pwengel/DIY-GPSDO/README.md

# DIY-GPSDO

Bearbeitet von Lukas

Paste the contents (2 files) of the symbols folder into [for me, this is Dokumente]/KiCad/8.0/symbols/
Symbols for the Pico: https://github.com/ncarandini/KiCad-RP-Pico
