pwengel/DIY-GPSDO/Frequency-Quadrupler-LTSpice/Draft1.asc

A1: xor; Vhigh=5 Vlow=0 Ref=1.0
A2: xor; Vhigh=5 Vlow=0 Ref=1.0
C1: cap; 0.1µ
C2: cap; 40p
C3: cap; 0.1µ
C4: cap; 40p
R1: res; 5.1k
R2: res; 5.1k
R3: res; 2k
R4: res; 5.1k
R5: res; 5.1k
R6: res; 900
U1: LT1720
U2: LT1720
V1: voltage; PULSE(0 5 0 0.1e-12 0.1e-12 0.5e-7 1e-7 200)
V2: voltage; 5
Named nets: 0
RC = 2/(3f_double)
.tran 0 50e-7 0 1e-11
RC = 2/(3f_double)
