pwengel/DIY-GPSDO/GPSDO_DIP/GPSDO_DIP/GPSDO_DIP.kicad_pcb

## KiCad design GPSDO_DIP/GPSDO_DIP/GPSDO_DIP.kicad_pcb (2024-07-01)

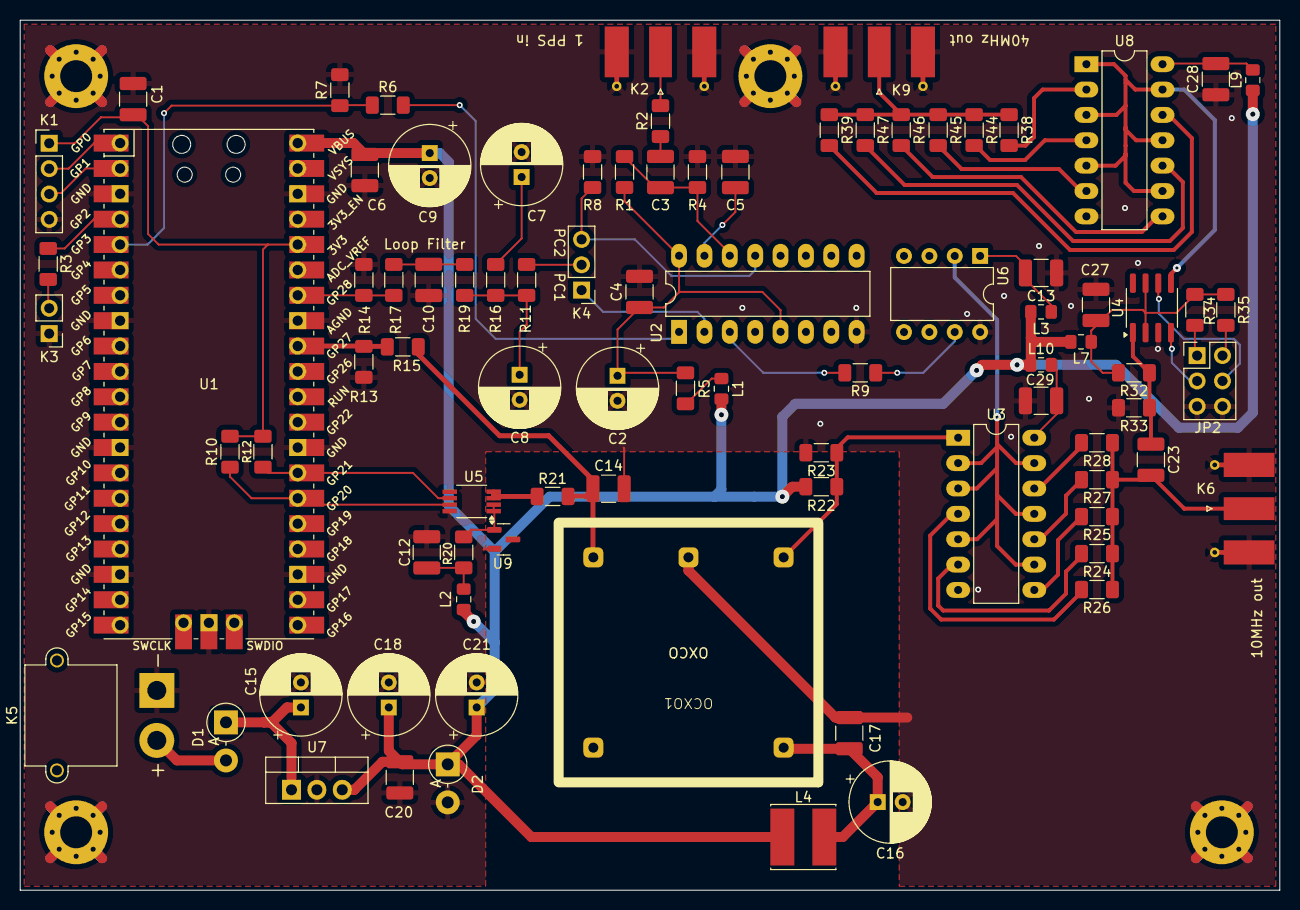
[picture p1: board GPSDO_DIP.kicad_pcb from above]

Board: 2 copper layers, 126.1 x 87.1 mm, 87 parts (0 on the bottom side), 59 nets.

Parts:
C1, C4, C6, C12, C13, C14, C17, C20, C23, C27, C28, C29: 100n; C_1210_3225Metric_Pad1.33x2.70mm_HandSolder
C2, C7, C16, C21: 47µ; CP_Radial_D8.0mm_P2.50mm
C3, C10: 1µ; C_1210_3225Metric_Pad1.33x2.70mm_HandSolder
C5: 2.2n; C_1210_3225Metric_Pad1.33x2.70mm_HandSolder
C8: 22µ; CP_Radial_D8.0mm_P2.50mm
C9: 220µ; CP_Radial_D8.0mm_P2.50mm
C15, C18: 470µ; CP_Radial_D8.0mm_P2.50mm
D1: SS24; D_DO-15_P3.81mm_Vertical_AnodeUp
D2: D; D_DO-15_P3.81mm_Vertical_AnodeUp
JP2: Conn_02x03_Odd_Even; PinHeader_2x03_P2.54mm_Vertical
K1: Conn_01x04; PinHeader_1x04_P2.54mm_Vertical
K2, K6, K9: Conn_Coaxial; SMA_Molex_73251-1153_EdgeMount_Horizontal
K3: Conn_01x02; PinHeader_1x02_P2.54mm_Vertical
K4: Jumper_3_Open; PinHeader_1x03_P2.54mm_Vertical
K5: Conn_01x02; AMASS_XT30PW-M_1x02_P2.50mm_Horizontal
L1, L2: 100µ; L_0805_2012Metric_Pad1.15x1.40mm_HandSolder
L3, L7, L9, L10: 10µ; L_0805_2012Metric_Pad1.15x1.40mm_HandSolder
L4: 10µ; L_Cenker_CKCS6045
OCXO1: OSC5A2B02
R1, R4, R16, R22, R23: 22k; R_1206_3216Metric_Pad1.30x1.75mm_HandSolder
R2, R19, R24, R25, R26, R27, R28, R38, R39, R44, R45, R46, R47: 240; R_1206_3216Metric_Pad1.30x1.75mm_HandSolder
R3, R20: 1k; R_1206_3216Metric_Pad1.30x1.75mm_HandSolder
R5: 22; R_1206_3216Metric_Pad1.30x1.75mm_HandSolder
R6, R15, R17: 27k; R_1206_3216Metric_Pad1.30x1.75mm_HandSolder
R7, R13, R14: 47k; R_1206_3216Metric_Pad1.30x1.75mm_HandSolder
R8: 1M; R_1206_3216Metric_Pad1.30x1.75mm_HandSolder
R9, R21: 680; R_1206_3216Metric_Pad1.30x1.75mm_HandSolder
R10, R12: 10k; R_1206_3216Metric_Pad1.30x1.75mm_HandSolder
R11: 160k; R_1206_3216Metric_Pad1.30x1.75mm_HandSolder
R32, R33: 100k; R_1206_3216Metric_Pad1.30x1.75mm_HandSolder
R34, R35: 4.7k; R_1206_3216Metric_Pad1.30x1.75mm_HandSolder
U1: Pico; RPi_Pico_SMD_TH
U2: DIP-16_W7.62mm_LongPads
U3, U8: 74HC14; DIP-14_W7.62mm_LongPads
U4: U1; SOIC-8_3.9x4.9mm_P1.27mm
U5: DAC8571IDGK; VSSOP-8_3.0x3.0mm_P0.65mm
U6: PIC12F675-xP; DIP-8_W7.62mm
U7: LM7805_TO220; TO-220-3_Vertical
U9: LM4040DBZ-4.1; SOT-23

Connections:
/VCC: C6.1, C7.1, C18.1, C20.1, C21.1, D2.1 (K), L1.2, L2.2, L3.1, L4.1, L7.2, L9.1, L10.1, R22.1, U1.40 (VBUS), U7.3 (VO)
/V_LPF: C10.2, R17.2, R19.1
/V_OCXO: C14.1, OCXO1.3 (Vcont), R15.2, R21.1
GND: C1.2, C2.2, C4.2, C5.1, C6.2, C7.2, C8.2, C9.2, C10.1, C12.2, C13.1, C14.2, C15.2, C16.2, C17.2, C18.2, C20.2, C21.2, C27.2, C28.1, C29.1, D2.2 (A), JP2.5, JP2.6, K1.4, K2.2 (Ext), K3.1, K5.1, K6.2 (Ext), K9.2 (Ext), OCXO1.2 (GND), R4.2, R7.2, R8.2, R13.2, R14.2, R23.2, R33.2, U1.3 (GND), U1.8 (GND), U1.13 (GND), U1.18 (GND), U1.23 (GND), U1.28 (GND), U1.33 (AGND), U1.38 (GND), U1.42 (GND), U2.8 (GND), U3.7 (GND), U4.3 (GND), U5.5 (A0), U5.8 (GND), U6.8 (VSS), U7.2 (GND), U8.7 (GND), U9.2 (A)
unnamed: C3.1, R2.1
unnamed: C8.1, R11.2, R16.1, R19.2
unnamed: C9.1, R16.2
unnamed: C12.1, L2.1, R20.1
unnamed: D1.2 (A), K5.2
unnamed: C15.1, D1.1 (K), U7.1 (VI)
unnamed: JP2.1, R34.1
unnamed: JP2.2, R35.2
unnamed: JP2.3, U4.4 (S1)
unnamed: JP2.4, U4.6 (S0)
unnamed: C1.1, K1.1, R10.2, R12.2, U1.36 (3V3)
unnamed: K1.2, U1.1 (GPIO0)
unnamed: K1.3, U1.2 (GPIO1)
unnamed: K2.1 (In), R2.2
unnamed: K3.2, R3.2
unnamed: K4.1 (A), U2.2 (PC1_out)
unnamed: K4.3 (B), R8.1, U2.13 (PC2_out)
unnamed: K4.2 (C), R11.1
unnamed: C23.2, K6.1 (In), R24.1, R25.1, R26.1, R27.1, R28.1
unnamed: K9.1 (In), R38.1, R39.1, R44.1, R45.1, R46.1, R47.1
unnamed: L1.1, R5.1
unnamed: OCXO1.1 (10MHz), R22.2, R23.1, U3.1
unnamed: C16.1, C17.1, L4.2, OCXO1.5 (VCC)
unnamed: R24.2, U3.6
unnamed: R25.2, U3.8
unnamed: R26.2, U3.4
unnamed: R27.2, U3.10
unnamed: R28.2, U3.12
unnamed: R38.2, U8.2
unnamed: R39.2, U8.12
unnamed: R44.2, U8.4
unnamed: R45.2, U8.6
unnamed: R46.2, U8.8
unnamed: R47.2, U8.10
unnamed: R3.1, U1.4 (GPIO2)
unnamed: R6.1, R7.1, U1.5 (GPIO3)
unnamed: R10.1, U1.26 (GPIO20), U5.7 (SDA)
unnamed: R12.1, U1.27 (GPIO21), U5.6 (SCL)
unnamed: R13.1, R15.1, U1.32 (GPIO27_ADC1)
unnamed: R14.1, R17.1, U1.34 (GPIO28_ADC2)
unnamed: R9.2, U2.3 (COMP_in)
unnamed: C5.2, U2.15 (C_LD)
unnamed: C2.1, C4.1, R1.1, R5.2, U2.5 (INH), U2.16 (VCC)
unnamed: R6.2, U2.1 (LD)
unnamed: C3.2, R1.2, R4.1, U2.14 (SIG_in)
unnamed: C29.2, L10.2, U3.14 (VCC)
unnamed: U4.5 (CLK), U8.1, U8.3, U8.5, U8.9, U8.11, U8.13
unnamed: C27.1, L7.1, R32.1, R34.2, R35.1, U4.2 (VDD), U4.7 (OE)
unnamed: C23.1, R32.2, R33.1, U4.1 (X1/CLK)
unnamed: R20.2, U5.1 (V_{DD}), U5.2 (V_{REF}), U9.1 (K)
unnamed: R21.2, U5.3 (V_{SENSE}), U5.4 (V_{OUT})
unnamed: R9.1, U6.7 (GP0)
unnamed: U3.2, U3.3, U3.5, U3.9, U3.11, U3.13, U6.2 (GP5)
unnamed: C13.2, L3.2, U6.1 (VDD)
unnamed: C28.2, L9.2, U8.14 (VCC)
