pwengel/DIY-GPSDO/GPSDO/GPSDO.kicad_pcb

## KiCad design GPSDO/GPSDO.kicad_pcb (2024-06-26)

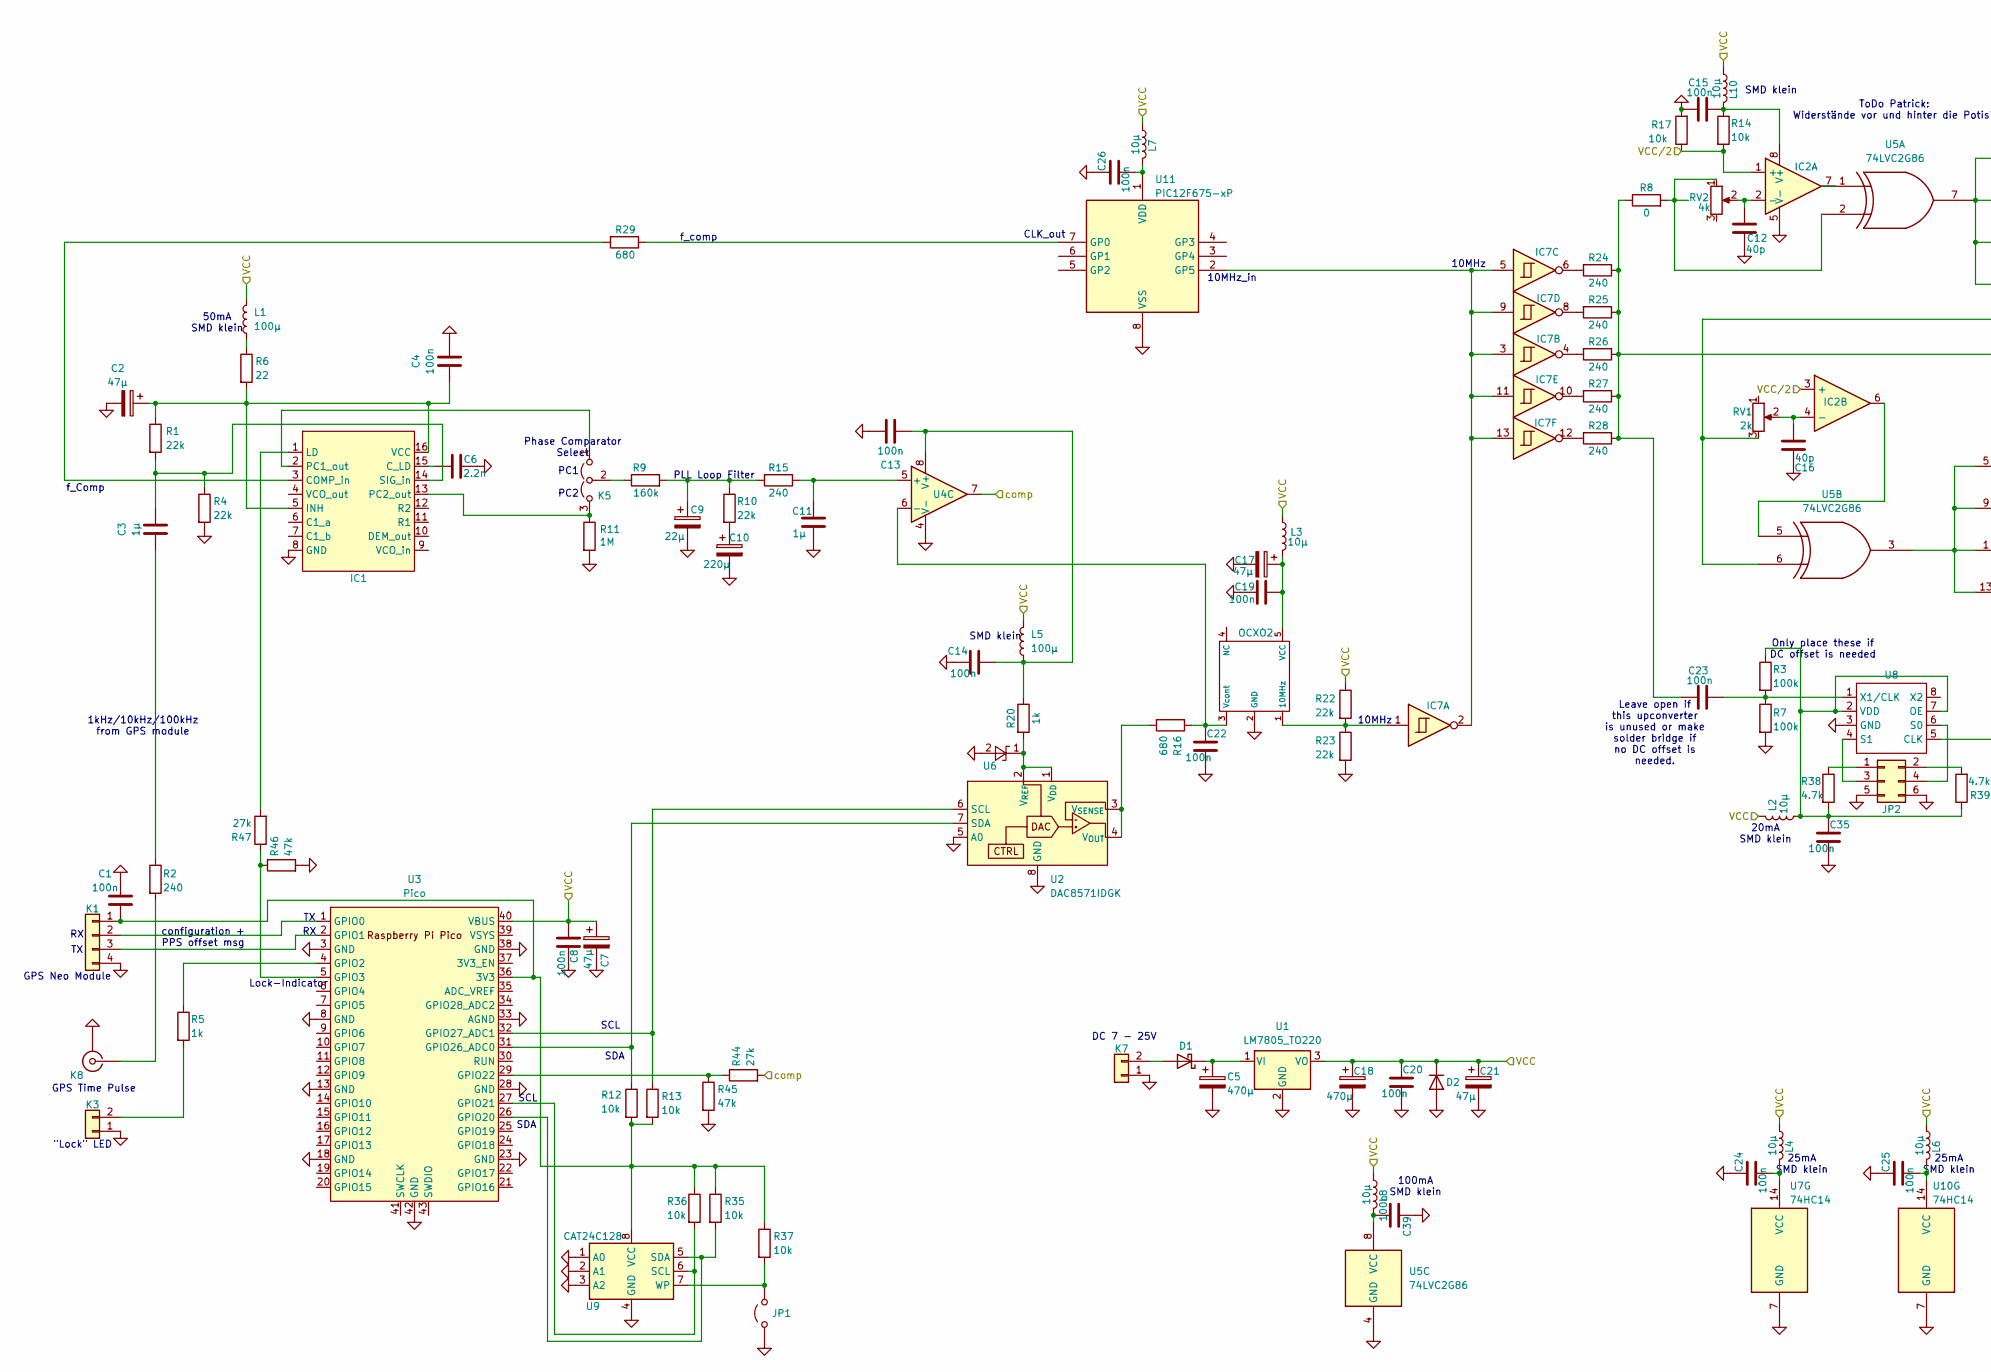
[picture p2: schematic GPSDO.kicad_sch, part in row 1, column 1]

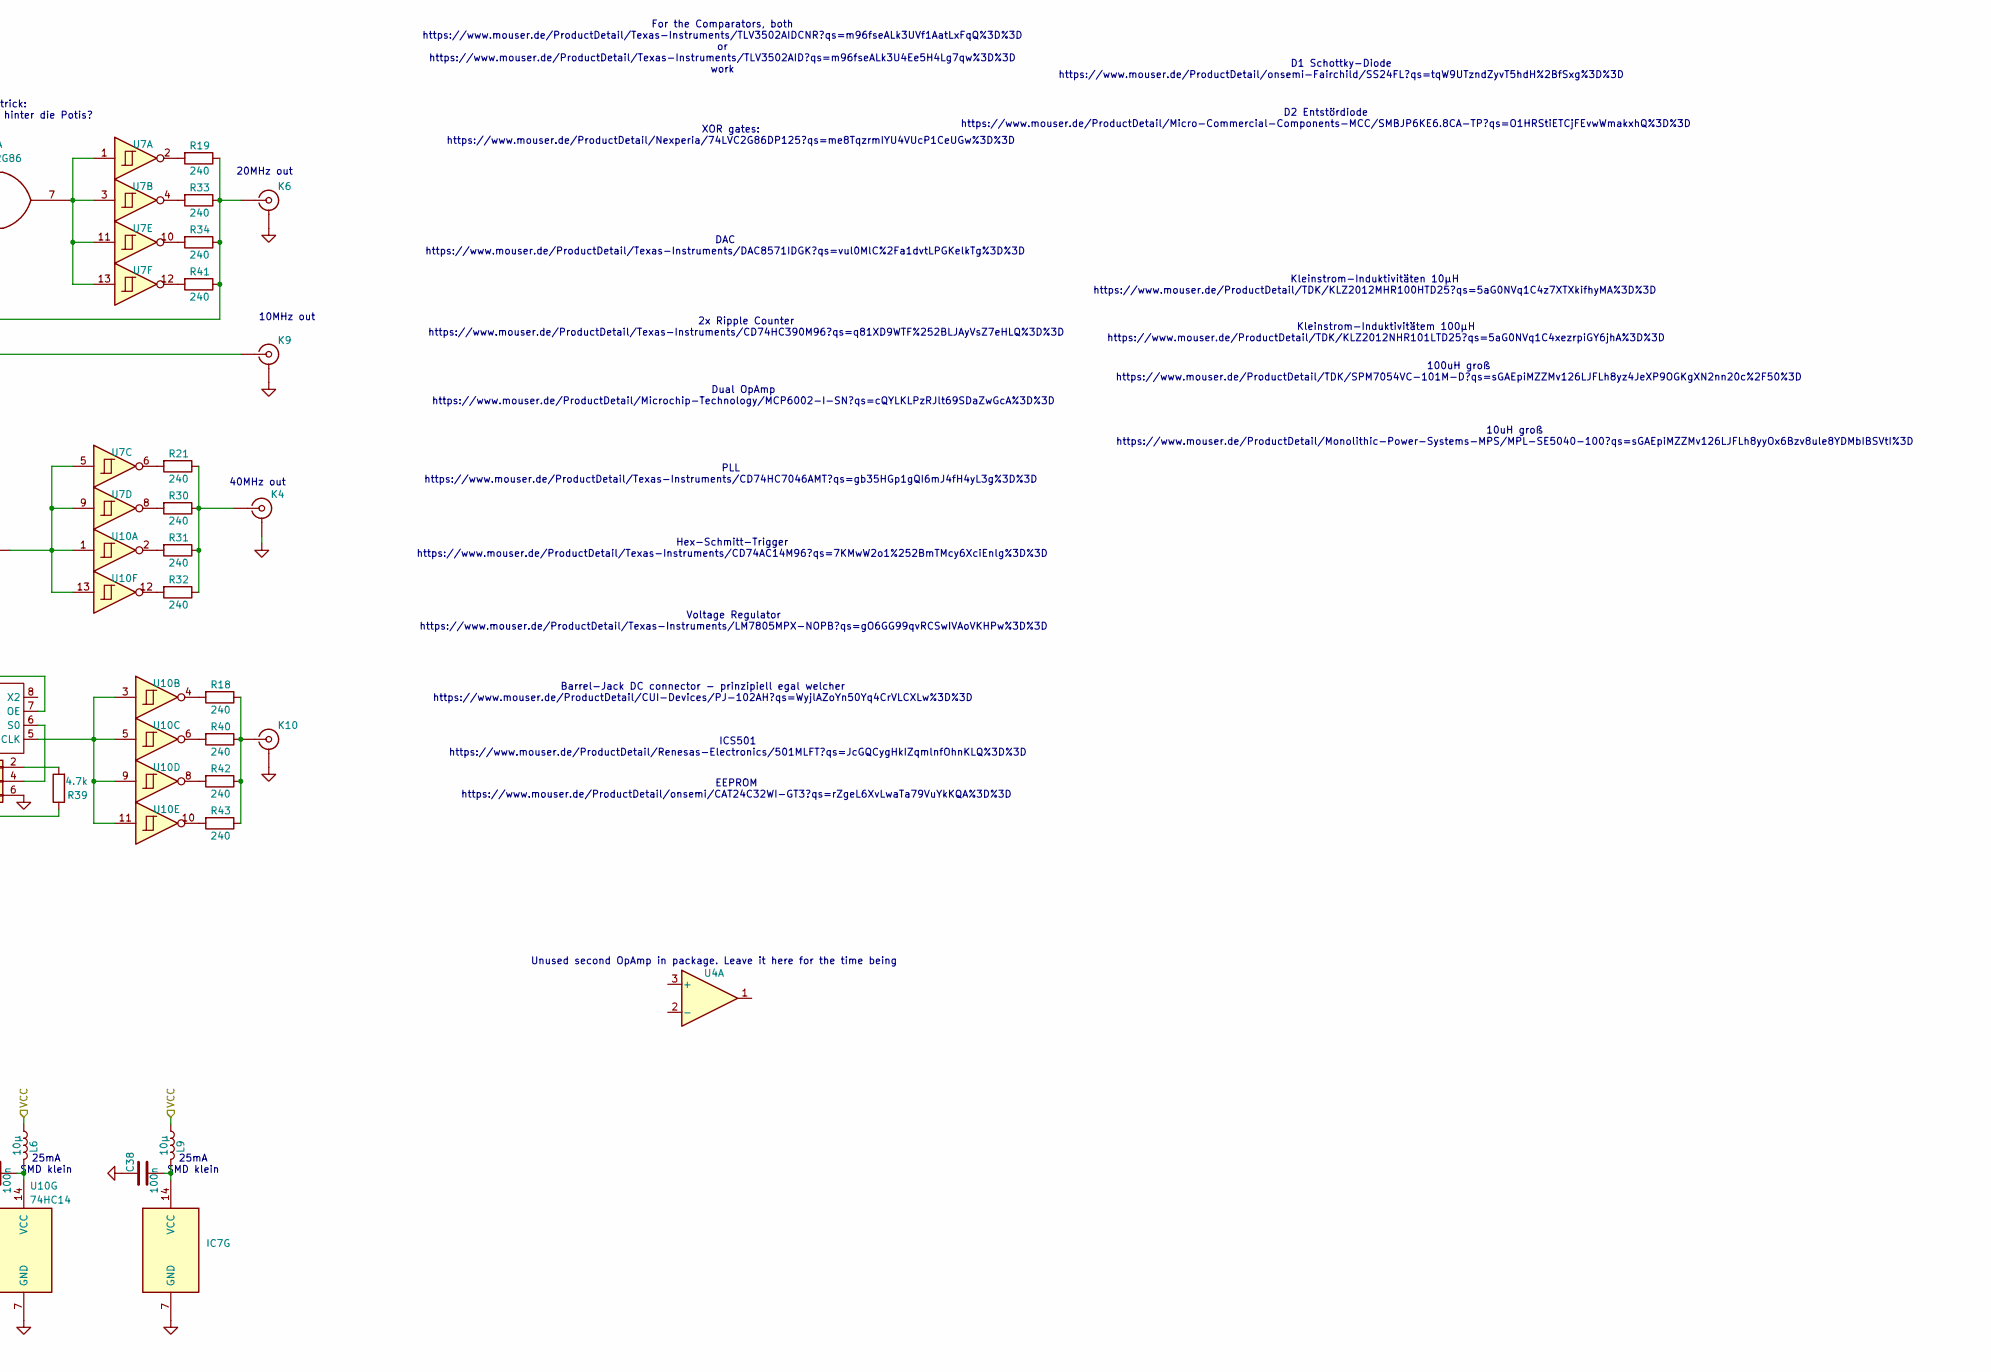
[picture p3: schematic GPSDO.kicad_sch, part in row 1, column 2]

Parts:
C1, C4, C8, C13, C14, C15, C19, C20, C22, C23, C24, C25, C26, C35, C38, C39: 100n; C_1210_3225Metric_Pad1.33x2.70mm_HandSolder
C2, C7, C17, C21: 47µ; CP_Elec_4x5.3
C3, C11: 1µ; C_Rect_L7.2mm_W5.5mm_P5.00mm_FKS2_FKP2_MKS2_MKP2
C5, C18: 470µ; CP_Elec_6.3x9.9
C6: 2.2n; C_1210_3225Metric_Pad1.33x2.70mm_HandSolder
C9: 22µ; CP_EIA-7343-43_Kemet-X_Pad2.25x2.55mm_HandSolder
C10: 220µ; CP_EIA-7343-43_Kemet-X_Pad2.25x2.55mm_HandSolder
C12, C16: 40p; C_1210_3225Metric_Pad1.33x2.70mm_HandSolder
D1: SS24; D_SOD-123F
D2: D; D_SMB
IC1: SOIC-16_3.9x9.9mm_P1.27mm
IC2: SOT-23-8_Handsoldering
IC7: 74HC14; SOIC-14_3.9x8.7mm_P1.27mm
JP1: Jumper_2_Open; PinHeader_1x02_P2.54mm_Vertical
JP2: Conn_02x03_Odd_Even; PinHeader_2x03_P2.54mm_Vertical
K1: Conn_01x04; PinHeader_1x04_P2.54mm_Vertical
K3: Conn_01x02; PinHeader_1x02_P2.54mm_Vertical
K4, K6, K8, K9, K10: Conn_Coaxial; SMA_Molex_73251-1153_EdgeMount_Horizontal
K5: Jumper_3_Open; PinHeader_1x03_P2.54mm_Vertical
K7: Conn_01x02; AMASS_XT30PW-M_1x02_P2.50mm_Horizontal
L1, L5: 100µ; L_0805_2012Metric_Pad1.15x1.40mm_HandSolder
L2, L4, L6, L7, L8, L9, L10: 10µ; L_0805_2012Metric_Pad1.15x1.40mm_HandSolder
L3: 10µ; L_Cenker_CKCS6045
OCXO2: OSC5A2B02
R1, R4, R10, R22, R23: 22k; R_0805_2012Metric_Pad1.20x1.40mm_HandSolder
R2, R15, R18, R19, R21, R24, R25, R26, R27, R28, R30, R31, R32, R33, R34, R40, R41, R42, R43: 240; R_0805_2012Metric_Pad1.20x1.40mm_HandSolder
R3, R7: 100k; R_0805_2012Metric_Pad1.20x1.40mm_HandSolder
R5, R20: 1k; R_0805_2012Metric_Pad1.20x1.40mm_HandSolder
R6: 22; R_0805_2012Metric_Pad1.20x1.40mm_HandSolder
R8: 0; R_0805_2012Metric_Pad1.20x1.40mm_HandSolder
R9: 160k; R_0805_2012Metric_Pad1.20x1.40mm_HandSolder
R11: 1M; R_0805_2012Metric_Pad1.20x1.40mm_HandSolder
R12, R13, R14, R17, R35, R36, R37: 10k; R_0805_2012Metric_Pad1.20x1.40mm_HandSolder
R16, R29: 680; R_0805_2012Metric_Pad1.20x1.40mm_HandSolder
R38, R39: 4.7k; R_0805_2012Metric_Pad1.20x1.40mm_HandSolder
R44, R47: 27k; R_0805_2012Metric_Pad1.20x1.40mm_HandSolder
R45, R46: 47k; R_0805_2012Metric_Pad1.20x1.40mm_HandSolder
RV1: 2k; Potentiometer_Bourns_3314S_Horizontal
RV2: 4k; Potentiometer_Bourns_3314J_Vertical
U1: LM7805_TO220; SOT-223-3_TabPin2
U2: DAC8571IDGK; VSSOP-8_3.0x3.0mm_P0.65mm
U3: Pico; RPi_Pico_SMD_TH
U4: AD8620; SOIC-8_3.9x4.9mm_P1.27mm
U5: 74LVC2G86; TSSOP-8_3x3mm_P0.65mm
U6: LM4040DBZ-4.1; SOT-23
U7, U10: 74HC14; SOIC-14_3.9x8.7mm_P1.27mm
U8: U1; SOIC-8_3.9x4.9mm_P1.27mm
U9: CAT24C128; SOIC-8_3.9x4.9mm_P1.27mm
U11: PIC12F675-xP; DIP-8_W7.62mm

Connections:
/VCC: C7.1, C8.1, C18.1, C20.1, C21.1, D2.1 (K), L1.2, L2.2, L3.1, L4.1, L5.2, L6.1, L7.1, L8.1, L9.1, L10.1, R22.1, U1.3 (VO), U3.40 (VBUS)
/VCC/2: IC2.1 (+), IC2.3 (+), R14.2, R17.1
/comp: R44.2, U4.7
GND: C1.2, C2.2, C4.2, C5.2, C6.1, C7.2, C8.2, C9.2, C10.2, C11.1, C12.1, C13.2, C14.2, C15.2, C16.1, C17.2, C18.2, C19.2, C20.2, C21.2, C22.2, C24.1, C25.1, C26.1, C35.2, C38.1, C39.1, D2.2 (A), IC1.8 (GND), IC2.5 (V-), IC7.7 (GND), JP1.1 (A), JP2.5, JP2.6, K1.4, K3.1, K4.2 (Ext), K6.2 (Ext), K7.1, K8.2 (Ext), K9.2 (Ext), K10.2 (Ext), OCXO2.2 (GND), R4.2, R7.2, R11.2, R17.2, R23.2, R45.2, R46.2, U1.2 (GND), U2.5 (A0), U2.8 (GND), U3.3 (GND), U3.8 (GND), U3.13 (GND), U3.18 (GND), U3.23 (GND), U3.28 (GND), U3.33 (AGND), U3.38 (GND), U3.42 (GND), U4.4 (V-), U5.4 (GND), U6.2 (A), U7.7 (GND), U8.3 (GND), U9.1 (A0), U9.2 (A1), U9.3 (A2), U9.4 (GND), U10.7 (GND), U11.8 (VSS)
unnamed: C3.1, R2.1
unnamed: C9.1, R9.2, R10.1, R15.2
unnamed: C10.1, R10.2
unnamed: D1.2 (A), K7.2
unnamed: C5.1, D1.1 (K), U1.1 (VI)
unnamed: IC1.3 (COMP_in), R29.2
unnamed: C6.2, IC1.15 (C_LD)
unnamed: C2.1, C4.1, IC1.5 (INH), IC1.16 (VCC), R1.1, R6.2
unnamed: IC1.1 (LD), R47.2
unnamed: IC1.2 (PC1_out), K5.1 (A)
unnamed: IC1.13 (PC2_out), K5.3 (B), R11.1
unnamed: C3.2, IC1.14 (SIG_in), R1.2, R4.1
unnamed: IC2.6, U5.5
unnamed: IC2.7, U5.1
unnamed: C12.2, IC2.2 (-), RV2.2
unnamed: C15.1, IC2.8 (V+), L10.2, R14.1
unnamed: C16.2, IC2.4 (-), RV1.2
unnamed: IC7.4, R26.2
unnamed: IC7.6, R24.2
unnamed: IC7.8, R25.2
unnamed: IC7.10, R27.2
unnamed: IC7.12, R28.2
unnamed: C38.2, IC7.14 (VCC), L9.2
unnamed: JP1.2 (B), R37.2, U9.7 (WP)
unnamed: JP2.1, R38.1
unnamed: JP2.2, R39.2
unnamed: JP2.3, U8.4 (S1)
unnamed: JP2.4, U8.6 (S0)
unnamed: C1.1, K1.1, R12.2, R13.2, R35.1, R36.1, R37.1, U3.36 (3V3), U9.8 (VCC)
unnamed: K1.2, U3.1 (GPIO0)
unnamed: K1.3, U3.2 (GPIO1)
unnamed: K3.2, R5.2
unnamed: K4.1 (In), R21.1, R30.1, R31.1, R32.1
unnamed: K5.2 (C), R9.1
unnamed: K6.1 (In), R19.1, R33.1, R34.1, R41.1, RV1.3, U5.6
unnamed: K8.1 (In), R2.2
unnamed: C23.2, K9.1 (In), R8.1, R24.1, R25.1, R26.1, R27.1, R28.1
unnamed: K10.1 (In), R18.1, R40.1, R42.1, R43.1
unnamed: L1.1, R6.1
unnamed: IC7.1, OCXO2.1 (10MHz), R22.2, R23.1
unnamed: C17.1, C19.1, L3.2, OCXO2.5 (VCC)
unnamed: C22.1, OCXO2.3 (Vcont), R16.1, U4.6 (-)
unnamed: R8.2, RV2.1, U5.2
unnamed: R18.2, U10.4
unnamed: R19.2, U7.2
unnamed: R21.2, U7.6
unnamed: R30.2, U7.8
unnamed: R31.2, U10.2
unnamed: R32.2, U10.12
unnamed: R33.2, U7.4
unnamed: R34.2, U7.10
unnamed: R40.2, U10.6
unnamed: R41.2, U7.12
unnamed: R42.2, U10.8
unnamed: R43.2, U10.10
unnamed: R13.1, U2.6 (SCL), U3.32 (GPIO27_ADC1)
unnamed: R12.1, U2.7 (SDA), U3.31 (GPIO26_ADC0)
unnamed: R20.2, U2.1 (V_{DD}), U2.2 (V_{REF}), U6.1 (K)
unnamed: R16.2, U2.3 (V_{SENSE}), U2.4 (V_{OUT})
unnamed: R5.1, U3.4 (GPIO2)
unnamed: R46.1, R47.1, U3.5 (GPIO3)
unnamed: R35.2, U3.26 (GPIO20), U9.5 (SDA)
unnamed: R36.2, U3.27 (GPIO21), U9.6 (SCL)
unnamed: R44.1, R45.1, U3.29 (GPIO22)
unnamed: C11.2, R15.1, U4.5 (+)
unnamed: C13.1, C14.1, L5.1, R20.1, U4.8 (V+)
unnamed: U5.7, U7.1, U7.3, U7.11, U7.13
unnamed: C39.2, L8.2, U5.8 (VCC)
unnamed: C24.2, L4.2, U7.14 (VCC)
unnamed: U8.5 (CLK), U10.3, U10.5, U10.9, U10.11
unnamed: C35.1, L2.1, R3.1, R38.2, R39.1, U8.2 (VDD), U8.7 (OE)
unnamed: C23.1, R3.2, R7.1, U8.1 (X1/CLK)
unnamed: U5.3, U7.5, U7.9, U10.1, U10.13
unnamed: C25.2, L6.2, U10.14 (VCC)
unnamed: R29.1, U11.7 (GP0)
unnamed: IC7.2, IC7.3, IC7.5, IC7.9, IC7.11, IC7.13, U11.2 (GP5)
unnamed: C26.2, L7.2, U11.1 (VDD)

Notes on the sheet:
ToDo Patrick: Widerstände vor und hinter die Potis?
XOR gates: https://www.mouser.de/ProductDetail/Nexperia/74LVC2G86DP125?qs=me8TqzrmIYU4VUcP1CeUGw%3D%3D
Kleinstrom-Induktivitätem 100µH https://www.mouser.de/ProductDetail/TDK/KLZ2012NHR101LTD25?qs=5aG0NVq1C4xezrpiGY6jhA%3D%3D
GPS Time Pulse
ICS501 https://www.mouser.de/ProductDetail/Renesas-Electronics/501MLFT?qs=JcGQCygHkIZqmlnfOhnKLQ%3D%3D
PLL https://www.mouser.de/ProductDetail/Texas-Instruments/CD74HC7046AMT?qs=gb35HGp1gQI6mJ4fH4yL3g%3D%3D
Hex-Schmitt-Trigger https://www.mouser.de/ProductDetail/Texas-Instruments/CD74AC14M96?qs=7KMwW2o1%252BmTMcy6XciEnlg%3D%3D
configuration + PPS offset msg
25mA SMD klein
SMD klein
40MHz out
"Lock" LED
50mA SMD klein
10MHz
Dual OpAmp https://www.mouser.de/ProductDetail/Microchip-Technology/MCP6002-I-SN?qs=cQYLKLPzRJlt69SDaZwGcA%3D%3D
2x Ripple Counter https://www.mouser.de/ProductDetail/Texas-Instruments/CD74HC390M96?qs=q81XD9WTF%252BLJAyVsZ7eHLQ%3D%3D
f_comp
10uH groß https://www.mouser.de/ProductDetail/Monolithic-Power-Systems-MPS/MPL-SE5040-100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
SDA
10MHz out
100uH groß https://www.mouser.de/ProductDetail/TDK/SPM7054VC-101M-D?qs=sGAEpiMZZMv126LJFLh8yz4JeXP9OGKgXN2nn20c%2F50%3D
D2 Entstördiode https://www.mouser.de/ProductDetail/Micro-Commercial-Components-MCC/SMBJP6KE6.8CA-TP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
Voltage Regulator https://www.mouser.de/ProductDetail/Texas-Instruments/LM7805MPX-NOPB?qs=gO6GG99qvRCSwIVAoVKHPw%3D%3D
f_Comp
Lock-Indicator
Leave open if this upconverter is unused or make solder bridge if no DC offset is needed.
CLK_out
EEPROM https://www.mouser.de/ProductDetail/onsemi/CAT24C32WI-GT3?qs=rZgeL6XvLwaTa79VuYkKQA%3D%3D
PLL Loop Filter
GPS Neo Module
Barrel-Jack DC connector - prinzipiell egal welcher https://www.mouser.de/ProductDetail/CUI-Devices/PJ-102AH?qs=WyjlAZoYn50Yq4CrVLCXLw%3D%3D
DC 7 - 25V
Only place these if DC offset is needed
DAC https://www.mouser.de/ProductDetail/Texas-Instruments/DAC8571IDGK?qs=vul0MlC%2Fa1dvtLPGKelkTg%3D%3D
20mA SMD klein
100mA SMD klein
SCL
Phase Comparator Select
Unused second OpAmp in package. Leave it here for the time being
PC1 PC2
Kleinstrom-Induktivitäten 10µH https://www.mouser.de/ProductDetail/TDK/KLZ2012MHR100HTD25?qs=5aG0NVq1C4z7XTXkifhyMA%3D%3D
1kHz/10kHz/100kHz from GPS module
For the Comparators, both https://www.mouser.de/ProductDetail/Texas-Instruments/TLV3502AIDCNR?qs=m96fseALk3UVf1AatLxFqQ%3D%3D or https://www.mouser.de/ProductDetail/Texas-Instruments/TLV3502AID?qs=m96fseALk3U4Ee5H4Lg7qw%3D%3D work
D1 Schottky-Diode https://www.mouser.de/ProductDetail/onsemi-Fairchild/SS24FL?qs=tqW9UTzndZyvT5hdH%2BfSxg%3D%3D
10MHz_in
20MHz out

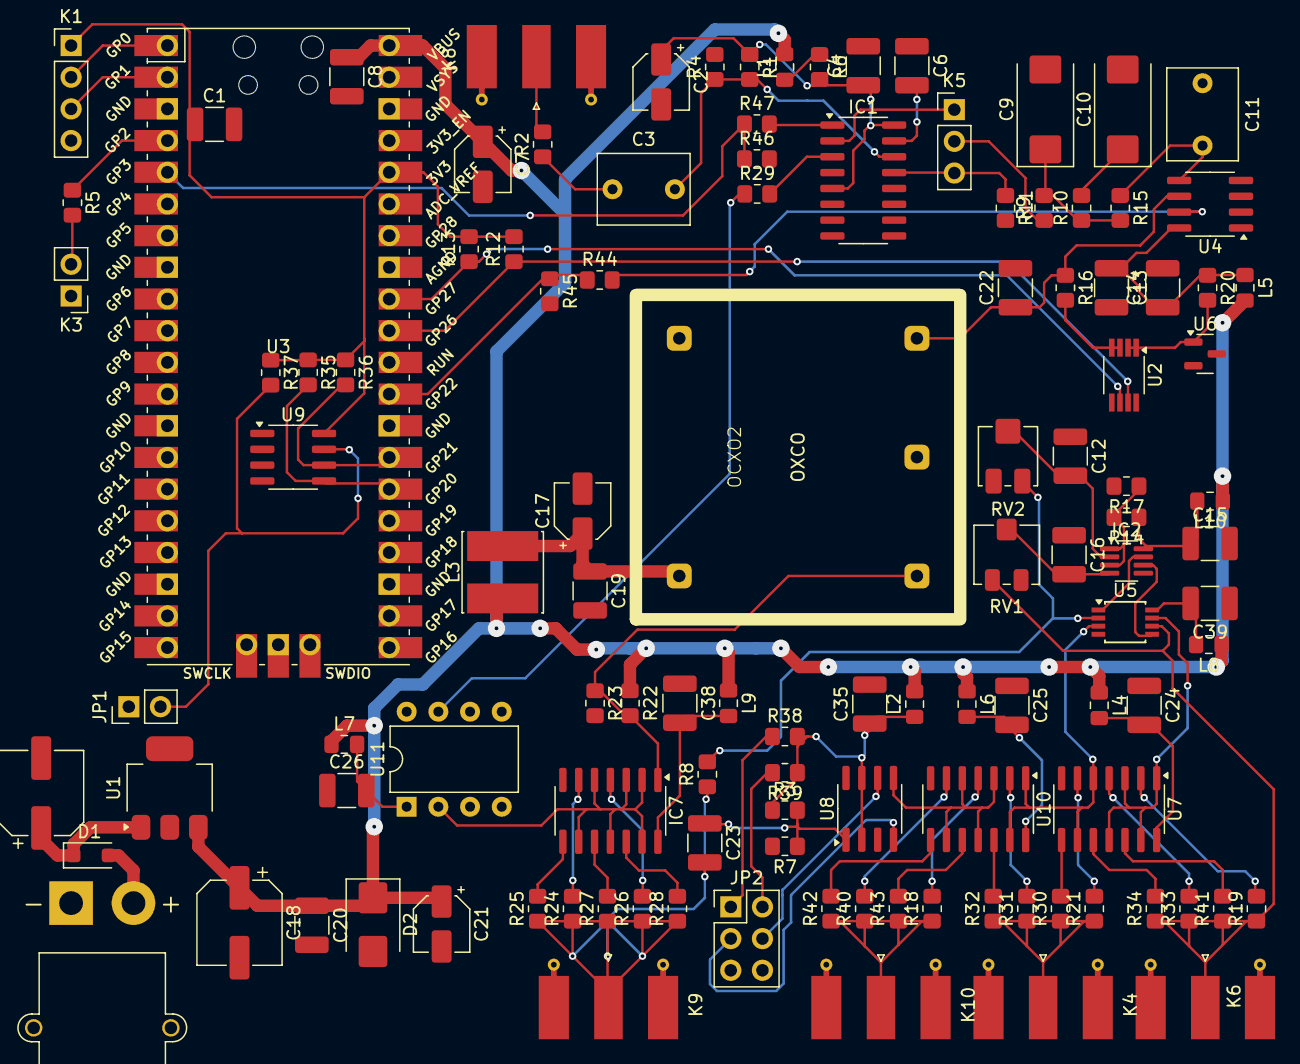
[picture p4: board GPSDO.kicad_pcb from above]

Board: 2 copper layers, 116 parts (0 on the bottom side), 81 nets.
