pwengel/DIY-GPSDO/(commit log)

2024-04-12 added KiCad Project
    [GPSDO.kicad_pcb, GPSDO.kicad_sch]
2024-04-14 changed schematic, OCXO symbol from Gibbi
    [GPSDO.kicad_sch]
2024-04-19 Add Frequency Multiplier and Pico
    [GPSDO.kicad_sch]
2024-04-22 minor schematic changes, added most footprints
    [GPSDO.kicad_sch]
2024-04-22 added footprints and Mouser Links to components
    [GPSDO.kicad_sch]
2024-04-24 Started Layout (WIP), minor schematic changes (3.3V supply to GPS neo module, removed voltage divider, since RPico Pins already provide 3.3V only)
    [GPSDO.kicad_pcb, GPSDO.kicad_sch]
2024-05-04 Changed VCC network, added ICS501 frequency multiplier
    [GPSDO.kicad_pcb, GPSDO.kicad_sch]
2024-05-09 added voltage reference to DAC
    [GPSDO.kicad_pcb, GPSDO.kicad_sch]
2024-05-09 buffers added + cleanup
    [GPSDO.kicad_sch]
2024-05-12 Layout almost done (GND plane & edge cuts missing), replaced counters with PIC 12F675 MCU for more flexible down conversion and less ICs on the PCB
    [GPSDO.kicad_pcb, GPSDO.kicad_sch]
2024-05-15 VCC net width fix, added voltage dividers for Pico inputs
    [GPSDO.kicad_pcb, GPSDO.kicad_sch]
2024-06-26 Added GPSDO prototype schematic with DIP ICs
    [GPSDO.kicad_pcb, GPSDO.kicad_sch, GPSDO_DIP.kicad_pcb, GPSDO_DIP.kicad_sch]
2024-07-01 added mounting holes & 10MHz SMA-port, cleaned up labels a bit
    [GPSDO_DIP.kicad_pcb, GPSDO_DIP.kicad_sch]
2024-10-10 MicroPython Project
    Add a MicroPython Project to programme the Raspbarry Pico which is used for digital processing inside the DIY-GPSDO.
